hildebkg/discipline-keyboard/doc/README.md

# DISCIPLINE

discipline

[Build Guide](DISCIPLINE+BUILD+GUIDE.pdf)

[VIA Configurator Guide (Easiest)](DISCIPLINE+VIA+GUIDE.pdf)

[QMK Toolbox Flashing Guide (not needed if using VIA)](DISCIPLINE+FLASHING+GUIDE.pdf)

[Command Line Flashing Guide (Advanced)](DISCIPLINE+FLASHING+GUIDE+-+COMMAND+LINE.pdf)

[Bootloader](./bootloader)

[Original BOM from coseyfannitutti](https://octopart.com/bom-tool/W4rybyut)

[My BOM (all Mouser)](https://octopart.com/bom-tool/y4uCnuVp)
