hildebkg/discipline-keyboard/(commit log)

2024-04-07 modified the front etch under the 'Discipline' logo
    [discipline-pcb.kicad_pcb, discipline-pcb.kicad_sch]
2024-04-08 changed /doc readme to include my updated BOM and to reference the added PDFs instead of the old website links
2024-05-20 final touches - added copper etch pattern to top of board, added name/version to bottom of board, re-generated gerber files
    [discipline-pcb-B_Cu.gbl, discipline-pcb-B_Mask.gbs, discipline-pcb-Edge_Cuts.gm1, discipline-pcb-F_Cu.gtl, discipline-pcb-F_Fab.gbr, discipline-pcb-F_Mask.gts, discipline-pcb-F_SilkS.gto, discipline-pcb-F_Silkscreen.gto]
2024-05-28 fixed silkscreen mistake - empty reference G** was displayed for name and revision number footprints
    [discipline-pcb-B_Cu.gbl, discipline-pcb-B_Mask.gbs, discipline-pcb-Edge_Cuts.gm1, discipline-pcb-F_Cu.gtl, discipline-pcb-F_Mask.gts, discipline-pcb-F_Silkscreen.gto, discipline-pcb-NPTH-drl.gbr, discipline-pcb-PTH-drl.gbr]
2024-09-19 added screenshots of all the custom acrylic case layers to the corresponding readme
2025-01-02 removed logo from keyboard plate design (janky Kicad fix + new Gerbers)
    [discipline-pcb.kicad_pcb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]
2025-01-03 changed bottom plate design to show the keyboard schematic on the silkscreen
    [discipline-pcb-B_Cu.gbl, discipline-pcb-B_Cu.gbr, discipline-pcb-B_Mask.gbr, discipline-pcb-B_Mask.gbs, discipline-pcb-B_SilkS.gbo, discipline-pcb-B_Silkscreen.gbr, discipline-pcb-Edge_Cuts.gbr, discipline-pcb-Edge_Cuts.gm1]
2025-01-03 added line to ignore any gerber zip files created
2025-01-03 small schematic changes: lengthened two pins on MCU symbol to improve readability for silkscreen, snapped all symbols to grid
    [discipline-pcb.kicad_sch]
